ohutanu/EM_MK5/ESP32_S3_pinout.md

# EM_MK5: ESP32-S3-WROOM-1 instead of the Raspberry Pi Pico (RP2040)

Date: 25 Oct 2026. Pins chosen from GPIO1-18, 21, 38-42 and 47, so they are free on every
WROOM-1 variant (no strapping, flash, PSRAM or USB pins). **[CONFIRM]** every pin against the
ESP32-S3-WROOM-1 module datasheet before routing the board.

| Pico signal | Pico pin | ESP32-S3 pin | Notes |
|---|---|---|---|
| PWM_CH1 to CH8 | GP6 to GP13 | GPIO4 to GPIO7, GPIO35, GPIO36, GPIO37, GPIO11 | Pairs (CH1,CH2) = IO4/IO5, (CH3,CH4) = IO6/IO7, (CH5,CH6) = IO35/IO36, (CH7,CH8) = IO37/IO11. MCPWM, hardware dead time. |
| SPI MOSI, CS, SCK, MISO (to the Pi) | GP16, GP17, GP18, GP19 | GPIO13, GPIO12, GPIO14, GPIO21 | SPI2 slave through the GPIO matrix (the fast IOMUX pins 10-13 are used by PWM). Keep the Pi clock to a few MHz. **[CONFIRM]** max slave clock. |
| MainSupp | GP28 (ADC2) | GPIO1 | ADC1 |
| 5V_Meas | GP27 (ADC1) | GPIO2 | ADC1 |
| 3.3V_Meas | GP26 (ADC0) | GPIO15 | ADC2 channel 4. Wi-Fi must stay off. |
| Analog_4 (was ADC_VREF) | pin 35 | GPIO16 | ADC2 channel 5. Wi-Fi must stay off. |
| Ext_Trigg1, Ext_Trigg2 | GP2, GP3 | GPIO17, GPIO18 | Outputs (read from the arrow shapes). |
| Ext_Trigg3, Ext_Trigg4 | GP21, GP22 | GPIO38, GPIO39 | Inputs. |
| UART TX / RX (J1) | GP0, GP1 | GPIO43 (TX0), GPIO44 (RX0) | Also the programming port. |
| I2C SDA / SCL (J2) | GP4, GP5 | GPIO41, GPIO42 | |
| Alarm LED (D3) | GP14 | GPIO40 | |
| pGood LED (D2) | GP15 | GPIO47 | **[CONFIRM]** GPIO47 may run at 1.8 V on octal-PSRAM modules, so the LED is dimmer. |
| RUN button (SW1) | RUN | EN | 10 kΩ pull-up to 3V3 plus 1 µF to GND, button to GND. |
| (none) | | GPIO0 to a BOOT button to GND | Download mode. |
| USB (optional) | | GPIO19 (D-), GPIO20 (D+) | Native USB programming, left unassigned. |

## Differences from the Pico board
- **3.3 V supply:** the module has no 3V3 output. Add an LDO of at least 600 mA (for example
  AP2112K-3.3) from +5 V, with 10 µF and 100 nF at input and output, in place of Pico pin 36.
  D1 (MBR130SFT) is only needed to OR USB 5 V with an external 5 V.
- **ADC range:** linear only up to about 2.5 V (about 3.1 V at the highest attenuation). Resize the
  dividers for MainSupp and 5V_Meas, and add a divider (for example 10 kΩ / 10 kΩ) on 3.3V_Meas.
  The ADC is not ratiometric to 3.3 V. Two inputs are on ADC2, which only works with Wi-Fi off.
  Calibrate and average samples. If this is a problem, move two signals to the AD4691 spare channels.
- **PWM:** MCPWM has a hardware dead-time generator. Use ESP-IDF (PlatformIO: board
  `esp32-s3-devkitc-1`, framework `espidf` or `arduino, espidf`).
- **SPI slave:** transaction-based with fixed length. Keep the Pi clock moderate (a few MHz).
- **Boot:** pins float during reset. The 10 kΩ pull-downs on the ULN2803 inputs keep the gates off.
- IO48 (module pin 25): Status LED (green) with 1 kΩ. Module is the N16R2 (quad flash, quad PSRAM), so IO47/IO48 are 3.3 V and IO35-IO37 are free.
- New analog inputs on ADC1: Analog_5 = IO8 (pin 12), Analog_6 = IO9 (pin 17), Analog_7 = IO10 (pin 18). Each has a divider, 1 kΩ and 100 nF, below about 2.5 V.
- Analog protection: every analog input has 1 kΩ, 100 nF and two BAT54 clamps at the pin (one to +2V5, one to GND). U4 REF3025 makes the +2V5 rail from +3V3 (1 µF out).
- Final analog map: IO1 MainSupp (52 V battery, 100k/3.9k), IO2 5V_Meas (12k/10k), IO15 3.3V_Meas (4.7k/10k, ADC2), IO8 12V_Meas (56k/10k), IO9 NTC1 and IO10 NTC2 (10 kΩ NTC to GND, 10 kΩ pull-up to +2V5). IO16 is spare. This replaces Analog_4 to Analog_7.
- Batt_V (battery 48 to 52 V, 58.4 V full): IO16 (pin 9, ADC2), 100k/3.9k, 1 kΩ, 100 nF and the BAT54 clamps.
- ADC1 only (Wi-Fi safe), final: IO1 MainSupp (52 V), IO2 5V_Meas, IO4 3.3V_Meas, IO5 Batt_V (48 to 52 V), IO8 12V_Meas, IO9 NTC1, IO10 NTC2. PWM_CH1/CH2 moved to IO15/IO16 (digital use of ADC2 pins), so pairs are IO15/IO16, IO6/IO7, IO35/IO36, IO37/IO11. This replaces the ADC2 assignments above.
- Final digital map: PWM_CH1/CH2 on IO38/IO39 (pins 31/32), so the pairs are IO38/IO39, IO6/IO7, IO35/IO36, IO37/IO11. Ext_Trigg1 to Ext_Trigg4 on IO17, IO18, IO15, IO16 (pins 10, 11, 8, 9), which are ADC2 pins used as digital I/O. Ext_Trigg1/2 are outputs, Ext_Trigg3/4 are inputs. This replaces the earlier PWM and trigger assignments.
- Final schematic: ESP32_S3_schematic_final.html/.png. Last free pins now carry User LED 1 to 3: IO3 (pin 15), IO45 (pin 26), IO46 (pin 16), each 1 kΩ to an LED to GND. These are strapping pins: keep the LEDs off during reset and boot.
- U4 changed to REF5025 (2.5 V, 0.05%), with a 1 kΩ bleed resistor from +2V5 to GND so the BAT54 clamps can sink current.
- NTC pull-ups now use a 4.096 V REF5040 (U8) with 22 kΩ pull-ups (keeps the pin under 2.5 V down to about 0 °C). REF5025 (U4) remains only as the +2V5 clamp rail.
- NTC1 is a 10 kΩ NTC (RT1) mounted on the board (no header). NTC2 stays on header J7 for the radiator sensor.
- Alarm LED (IO40) now drives an NPN (BC847, 1 kΩ base, 100 kΩ pull-down). LED from +5V with 150 Ω, about 20 mA.
- LEDs: only Alarm (IO40, transistor) and pGood (IO47). The Status LED and User LEDs were removed. IO48, IO3, IO45, IO46 are now buttons BTN1 to BTN4 (active high: button to +3V3, 10 kΩ pull-down, 1 kΩ series, 100 nF) for running without the Pi. Do not hold BTN2 to BTN4 at power-up or reset (strapping pins).
- Buttons moved to an MCP23008 I2C expander (U9, address 0x20, GP4 to GP7, BTN1 to BTN4), on the ESP32 I2C bus (IO41/IO42). INT goes to IO48 (MCP_INT). IO3, IO45, IO46 are free again. The user plans to use freed ESP32 pins as SPI chip selects (to be defined).
- U10 ULN2003A: IN1 = Ext_Trigg1 (IO17), IN2 = Ext_Trigg2 (IO18), IN3 = FAN_PWM (IO3, pin 15). OUT1/OUT2 go to header J11 (open collector), OUT3 to the fan on J12 (FAN-). COM to +12V. J13 is the 12 V input. 10 kΩ pull-downs keep the outputs off at reset. IO45 and IO46 remain free.
- Q2 (first Si2366DS, now DMG3406L-13: SOT-23, 30 V, 3.6 A, Vgs max ±20 V, Rds(on) 50 mΩ max at 10 V) switches a 12 V load up to 1 A. Gate on IO45 (pin 26, net LOAD_PWM) through 100 Ω, with a 100 kΩ pull-down. Protection: F1 PTC fuse 1.5 A hold on +12V, D2 SS14 flyback diode across the load, D3 SMAJ15A TVS from drain to GND. Load on J14 (+12V_F, LOAD-). IO46 is the only free pin left. IO45 is a strapping pin (VDD_SPI voltage), the 100 kΩ pull-down is safe at boot.
- IO45 pin protection: D4 BAT54S clamps the ESP32 side of the 100 Ω gate resistor to +3V3 and GND. D5 5.1 V zener (BZX84-C5V1) from gate to source protects the gate. Existing 100 kΩ gate pull-down kept.
- Q2 gate is now driven through optocoupler U11 (PC817): IO45 -> 330 Ω -> LED (about 6 mA). Phototransistor: collector to +12V, emitter to the gate, with a 10 kΩ gate pull-down and a 15 V zener gate to source (12 V gate drive, active high). The earlier D4 BAT54S and 5.1 V zener were removed. The PC817 is slow, so PWM up to about 1 kHz. Not galvanic isolation while the grounds are shared.
- Ext_Trigg3 and Ext_Trigg4 (inputs on IO15 and IO16) were dropped. IO15 (pin 8) and IO16 (pin 9) are free now, as is IO46. Only Ext_Trigg1/2 remain (IO17, IO18, outputs via U10).
- IO15 (pin 8) and IO16 (pin 9) are now the ADC chip selects: IO15 = CS for the AD4691, IO16 = CS for the MCP3208. Each goes through 100 Ω to header J15 (pin 1 AD4691, pin 2 MCP3208, pin 3 GND). Add 10 kΩ pull-ups to +3V3 on the ADC board CS lines. Free pins left: IO46 only. Still open: which device is the SPI master for SCK/MOSI/MISO on the ADC board (the Pi 5 or the ESP32).
- Q2 changed to DMG3406L-13 (30 V, 3.6 A, Vgs(th) 1.0 to 2.0 V, ±20 V gate, Rds(on) 50 mΩ max at 10 V, 70 mΩ at 4.5 V). Si2366DS, IRLML6344 and AO3400A were not available to buy. Keep the optocoupler 12 V gate drive and the 15 V zener D5.
- Removed from the final schematic (pins left free by the user): Alarm LED and Q1 driver (IO40), FAN_PWM and J12 fan (IO3, ULN2003A input 3 is now grounded), and the whole Q2 12 V load stage with optocoupler U11 (IO45). Free pins: IO3, IO40, IO45, IO46. The previous version (with Q2, DMG3406L-13) is in git history, commit bf22db7. As chip selects: IO40 is the safest (not a strapping pin). IO3 is also fine with a pull-up. Avoid external pull-ups on IO45 (flash voltage strap) and IO46 (boot strap).
- FAN_PWM is back, now on IO40 (pin 33) instead of IO3. It drives ULN2003A input 3, which sinks the fan on J12 (COM to +12V, RN4 10 kΩ pull-down keeps the fan off at reset). Free pins: IO3, IO45, IO46. Use LEDC PWM on IO40. Typical fan PWM frequency is 25 kHz for a 4-pin fan, or about 100 Hz to 1 kHz for a 2-wire fan switched by the ULN2003A.
- Fan control changed from ULN2003A input 3 to a MOSFET: Q2 DMN3150L-7 (30 V, 3.8 A, Vgs(th) 0.92 V max, Rds(on) 115 mΩ max at 2.5 V). FAN_PWM (IO40) goes through 100 Ω to the gate, with a 100 kΩ gate pull-down. D2 SS14 flyback diode across the fan, fan on J12 (+12V, FAN- to the drain). ULN2003A now only drives Ext_Trigg1/2. [CONFIRM] the Vgs max (assumed 12 V) and the SOT-23 pinout of the DMN3150L-7.
