ohutanu/EM_MK5/EM_MK5_adc_schematic.png

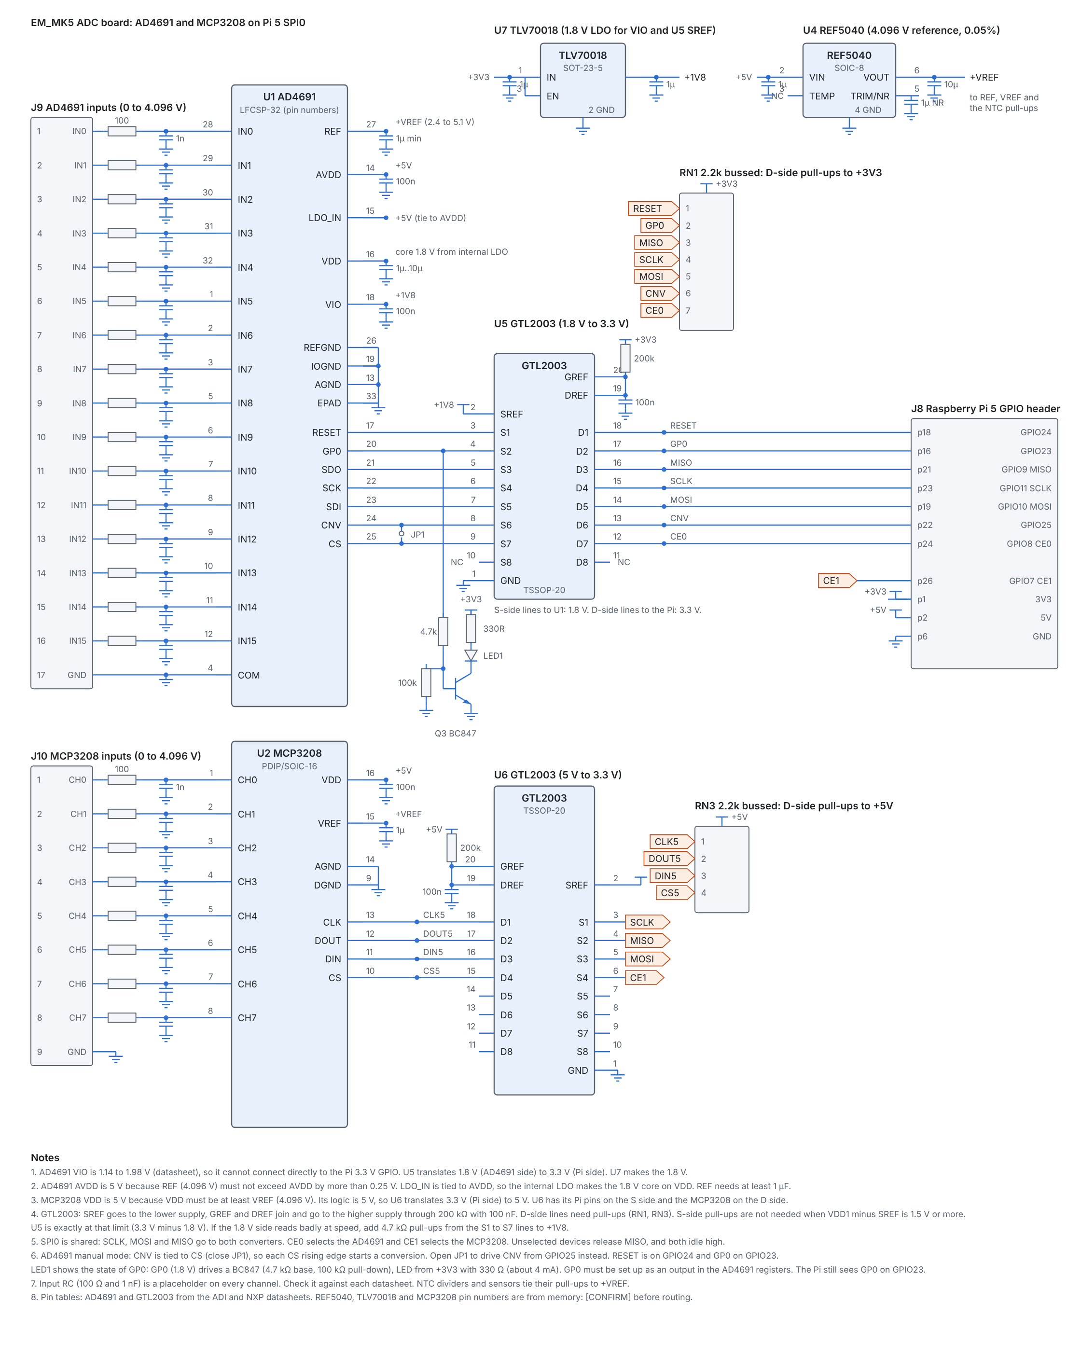
EM_MK5_adc_schematic.png
