ohutanu/EM_MK5/ESP32_S3_pin_to_pin.png

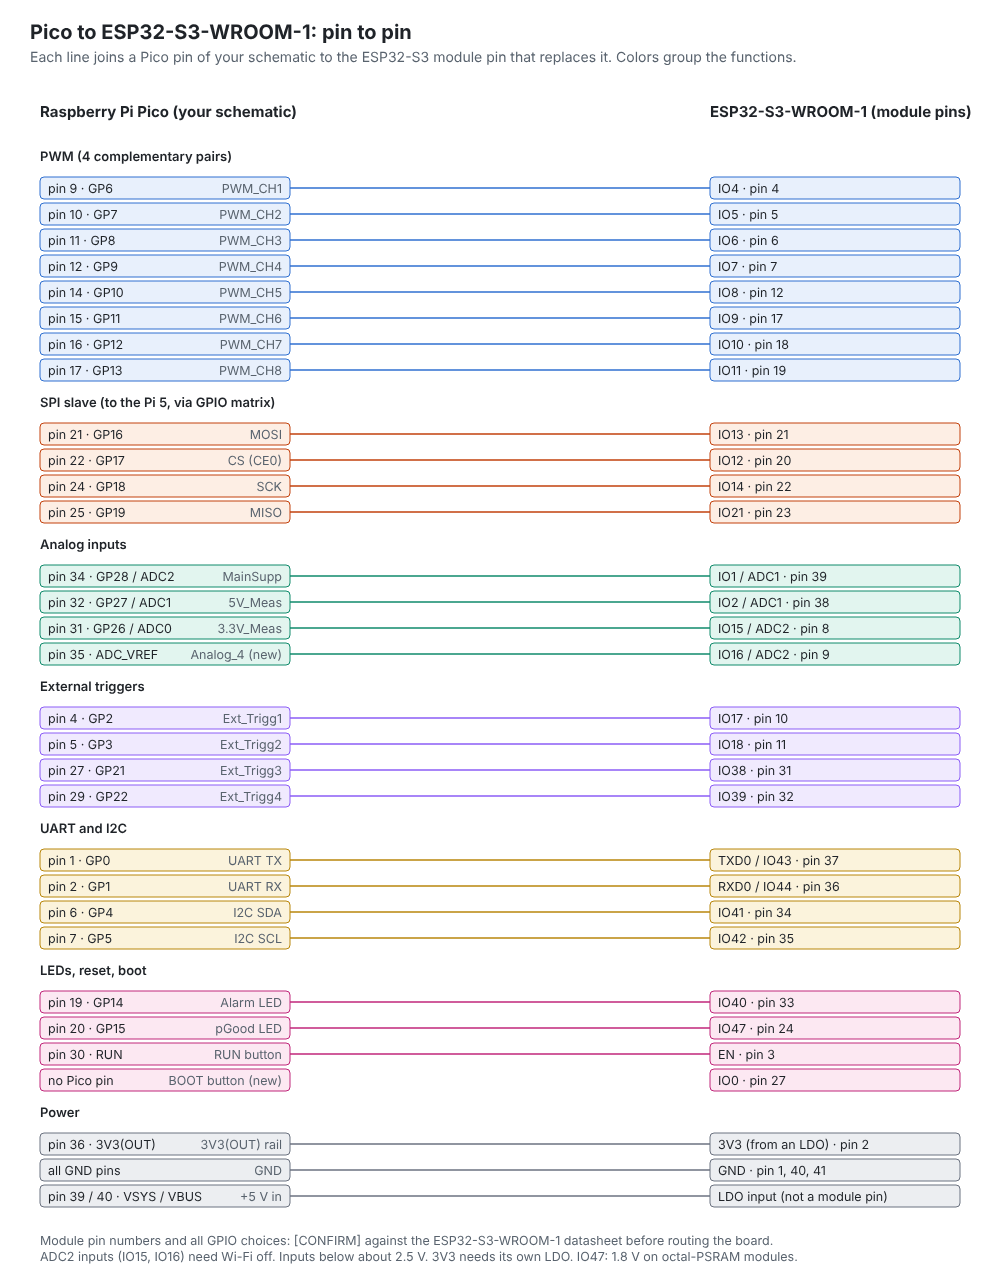
ESP32_S3_pin_to_pin.png
