ohutanu/EM_MK5/ESP32_S3_schematic_final.png

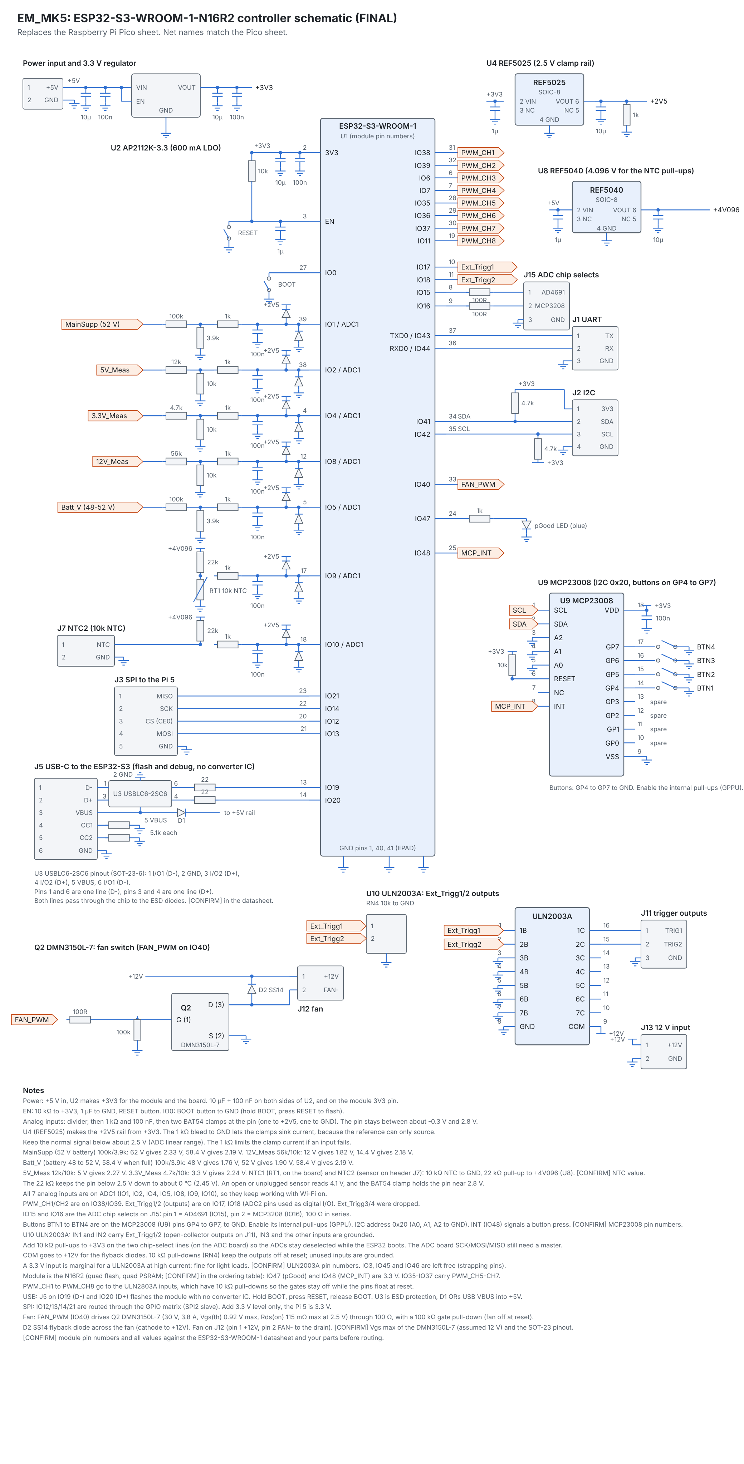
ESP32_S3_schematic_final.png
