ohutanu/EM_MK5/(commit log)

2026-10-11 Add EM_MK5 project summary v2 and diagrams
    Updated summary (October 2026) and a self-contained HTML file with all
    ten diagrams and schematics, including the four-latch trip design and
    the INA240 backup trip.
    Claude-Session: https://claude.ai/code/session_0174MNEmDaTV8DPD2QnVHENo
2026-10-11 Replace 74LVC244 LED buffer with ULN2803A (+5 V LED supply, 240 ohm)
    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
2026-10-11 Use BSS138 transistors for the enable optocoupler LEDs
    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
2026-10-11 Use one BSS138 for all enable optocoupler LEDs
    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
2026-10-11 Drive enable optocoupler LEDs directly from a 74HC21 AND, no transistor
    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
2026-10-11 Merge current trips into one comparator, add one-comparator radiator temperature trip, two latches
    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
2026-10-11 Use LTC6752 for the radiator temperature trip
    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
2026-10-11 Use 74LS279 on +5 V with 74HCT21 and Q dividers to the Pi
    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
2026-10-11 Four trip latches: CT, coil, battery, temperature
    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
2026-10-24 Add Raspberry Pi 5 AD4691 manual-mode read script
    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
2026-10-24 Add Arduino AD4691 manual-mode read sketch
    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
2026-10-25 Add ESP32-S3-WROOM-1 pin map as an alternative to the Pico
    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
2026-10-25 Add Pico to ESP32-S3 pin-to-pin diagram
    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
2026-10-25 Pin map: fourth analog input on GPIO9, Ext_Trigg3 moves to GPIO47
    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
2026-10-25 Fix label overlap in pin-to-pin diagram
    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
2026-10-25 Add RP2040 software dead-time PWM sketch for GP6-GP13
    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
2026-10-25 Add ESP32-S3 MCPWM hardware dead-time sketch
    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
2026-10-25 ESP32-S3: PWM on GPIO4-GPIO11, SPI/analog/trigger pins reassigned
    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
2026-10-25 Add ESP32-S3-WROOM-1 schematic (LDO, EN, BOOT, headers, all signals)
    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
2026-10-25 ESP32-S3 schematic: add USB-C (IO19/IO20, ESD, CC resistors, VBUS diode)
    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
2026-10-25 ESP32-S3 schematic: note N16 module (IO47/48 at 3.3 V)
    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
2026-10-25 ESP32-S3 schematic: add IO48 status LED
    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
2026-10-25 ESP32-S3 schematic: add USBLC6-2SC6 pinout
    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
2026-10-25 ESP32-S3: add Analog_5-7 on IO8/9/10, move PWM_CH5-7 to IO35/36/37
    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
2026-10-25 ESP32-S3 schematic: add REF3025 2.5 V clamp rail and BAT54 clamps on all analog inputs
    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
2026-10-25 ESP32-S3 schematic: 52V, 12V, 5V, 3.3V dividers and two NTC inputs
    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
2026-10-25 Add ADC board schematic: AD4691 + MCP3208 on Pi 5 SPI0 through two GTL2003, REF5040, TLV70018
    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
2026-10-25 ESP32-S3 schematic: add Batt_V input on IO16 (48-52 V battery)
    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
2026-10-25 ESP32-S3: all analog inputs on ADC1; PWM_CH1/CH2 moved to IO15/IO16
    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
2026-10-25 ESP32-S3: PWM_CH1/CH2 to IO38/IO39, Ext_Trigg to IO17/18/15/16
    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
2026-10-25 Note: module is ESP32-S3-WROOM-1-N16R2
    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
2026-10-25 Schematic notes: split long line
2026-10-25 ESP32-S3 final schematic: user LEDs on IO3/IO45/IO46, renamed to _final
    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
2026-10-25 Final schematic: REF5025 as 2.5 V reference, add 1k bleed on +2V5
    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
2026-10-25 Final schematic: NTC pull-ups on 4.096 V REF5040 (U8), 22k
2026-10-25 Final schematic: NTC1 on board (RT1)
2026-10-25 Final schematic: Alarm LED driven by NPN transistor from +5V
2026-10-25 Final schematic: remove extra LEDs, add four buttons on IO48/IO3/IO45/IO46
2026-10-25 Final schematic: buttons moved to MCP23008 expander on I2C
2026-10-25 Final schematic: ULN2003A for Ext_Trigg1/2 and fan control (FAN_PWM on IO3)
2026-10-25 Final schematic: Q2 Si2366DS 12 V load switch on IO45 with fuse, flyback diode and TVS
    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
2026-10-25 Final schematic: IO45 pin protection (BAT54S clamps, gate zener)
    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
2026-10-25 Final schematic: optocoupler U11 (PC817) between IO45 and Q2 gate, 12 V gate drive
    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
2026-10-25 Final schematic: drop Ext_Trigg3/4 (IO15, IO16 free)
    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
2026-10-25 Final schematic: fix clipped notes, Q2 and J14 label overlaps
    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
2026-10-25 Final schematic: IO15/IO16 as ADC chip selects on J15
    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
2026-10-25 ADC board: LED1 on AD4691 GP0 (BC847 driver), manual mode with CNV tied to CS
    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
2026-10-25 Final schematic: Q2 is DMG3406L-13
    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
2026-10-25 Final schematic: IO3, IO40, IO45, IO46 left free (alarm LED, fan, Q2 stage removed)
    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
2026-10-25 Final schematic: FAN_PWM on IO40 (ULN2003A input 3, J12 fan)
    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
2026-10-25 Final schematic: fan switched by MOSFET Q2 (DMN3150L-7) on IO40
    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
